lgszolnoki/CPU_Board/Eagle/rcbussbc.brd

## EAGLE design Eagle/rcbussbc.brd (2024-07-18)

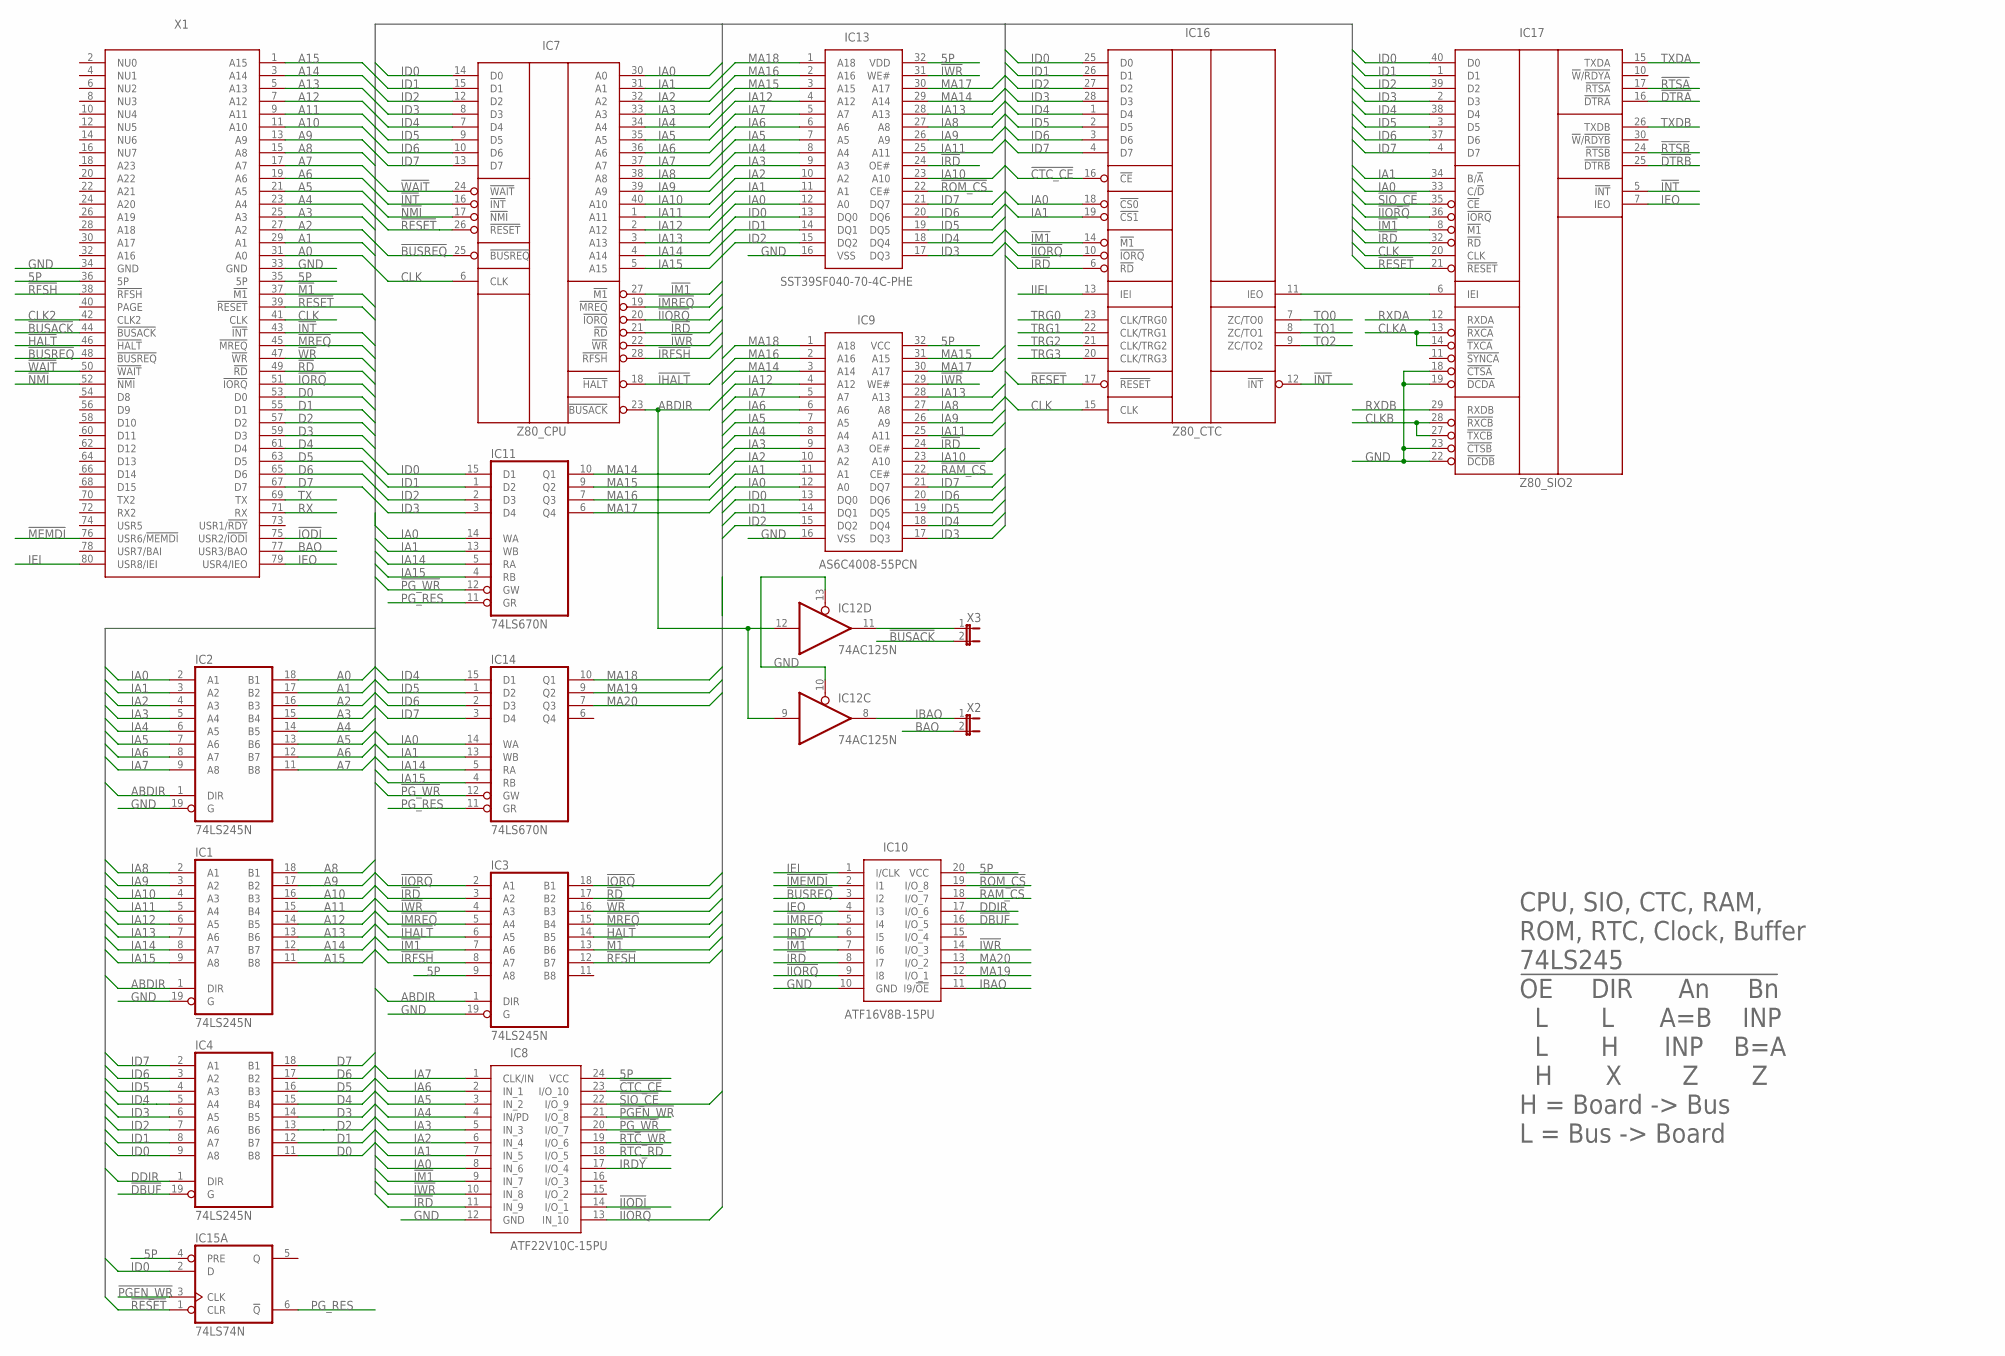
[picture p1: schematic rcbussbc.sch, sheet 1]

Parts:
IC1, IC2, IC3, IC4: 74LS245N; DIL20
IC7: Z80_CPU; DIP1612W53P254L5232H406Q40N
IC8: ATF22V10C-15PU; DIP794W56P254L3188H533Q24N
IC9: AS6C4008-55PCN; DIP1524W58P254L4191H406Q32N
IC10: ATF16V8B-15PU; DIP794W59P254L2591H533Q20N
IC11, IC14: 74LS670N; DIL16
IC12: 74AC125N; DIL14
IC13: SST39SF040-70-4C-PHE; DIP1556W56P254L4191H508Q32N
IC15: 74LS74N; DIL14
IC16: Z80_CTC; DIL28
IC17: Z80_SIO2; DIP1612W53P254L5232H406Q40N
X1: RCBUS_80_RA; RC2014_80_RA
X2, X3: JP1E; JP1

Connections:
5P: IC3.9 (A8), IC8.24 (VCC), IC9.32 (VCC), IC10.20 (VCC), IC13.32 (VDD), IC15.4 (PRE), X1.35 (5P), X1.36 (5P); also elsewhere on the board
!BUSACK: X1.44 (!BUSACK), X3.2
!BUSREQ: IC7.25 (!BUSREQ), IC10.3 (I2), X1.48 (!BUSREQ)
!CTC_CE: IC8.23 (I/O_10), IC16.16 (!CE)
!DBUF: IC4.19 (G), IC10.16 (I/O_5)
!DTRA: IC17.16 (!DTRA); also elsewhere on the board
!DTRB: IC17.25 (!DTRB); also elsewhere on the board
!HALT: IC3.14 (B5), X1.46 (!HALT)
!IHALT: IC3.6 (A5), IC7.18 (!HALT)
!IIODI: IC8.14 (I/O_1); also elsewhere on the board
!IIORQ: IC3.2 (A1), IC7.20 (!IORQ), IC8.13 (IN_10), IC10.9 (I8), IC16.10 (!IORQ), IC17.36 (!IORQ)
!IM1: IC3.7 (A6), IC7.27 (!M1), IC8.9 (IN_7), IC10.7 (I6), IC16.14 (!M1), IC17.8 (!M1)
!IMEMDI: IC10.2 (I1); also elsewhere on the board
!IMREQ: IC3.5 (A4), IC7.19 (!MREQ), IC10.5 (I4)
!INT: IC7.16 (!INT), IC16.12 (!INT), IC17.5 (!INT), X1.43 (!INT)
!IODI: X1.75 (USR2/!IODI); also elsewhere on the board
!IORQ: IC3.18 (B1), X1.51 (!IORQ)
!IRD: IC3.3 (A2), IC7.21 (!RD), IC8.11 (IN_9), IC9.24 (OE#), IC10.8 (I7), IC13.24 (OE#), IC16.6 (!RD), IC17.32 (!RD)
!IRFSH: IC3.8 (A7), IC7.28 (!RFSH)
!IWR: IC3.4 (A3), IC7.22 (!WR), IC8.10 (IN_8), IC9.29 (WE#), IC10.14 (I/O_3), IC13.31 (WE#)
!M1: IC3.13 (B6), X1.37 (!M1)
!MEMDI: X1.76 (USR6/!MEMDI); also elsewhere on the board
!MREQ: IC3.15 (B4), X1.45 (!MREQ)
!NMI: IC7.17 (!NMI), X1.52 (!NMI)
!PGEN_WR: IC8.21 (I/O_8), IC15.3 (CLK)
!PG_WR: IC8.20 (I/O_7), IC11.12 (GW), IC14.12 (GW)
!RAM_CS: IC9.22 (CE#), IC10.18 (I/O_7)
!RD: IC3.17 (B2), X1.49 (!RD)
!RESET: IC7.26 (!RESET), IC15.1 (CLR), IC16.17 (!RESET), IC17.21 (!RESET), X1.39 (!RESET); also elsewhere on the board
!RFSH: IC3.12 (B7), X1.38 (!RFSH)
!ROM_CS: IC10.19 (I/O_8), IC13.22 (CE#)
!RTC_RD: IC8.18 (I/O_5); also elsewhere on the board
!RTC_WR: IC8.19 (I/O_6); also elsewhere on the board
!RTSA: IC17.17 (!RTSA); also elsewhere on the board
!RTSB: IC17.24 (!RTSB); also elsewhere on the board
!SIO_CE: IC8.22 (I/O_9), IC17.35 (!CE)
!WAIT: IC7.24 (!WAIT), X1.50 (!WAIT)
!WR: IC3.16 (B3), X1.47 (!WR)
A0: IC2.18 (B1), X1.31 (A0)
A1: IC2.17 (B2), X1.29 (A1)
A2: IC2.16 (B3), X1.27 (A2)
A3: IC2.15 (B4), X1.25 (A3)
A4: IC2.14 (B5), X1.23 (A4)
A5: IC2.13 (B6), X1.21 (A5)
A6: IC2.12 (B7), X1.19 (A6)
A7: IC2.11 (B8), X1.17 (A7)
A8: IC1.18 (B1), X1.15 (A8)
A9: IC1.17 (B2), X1.13 (A9)
A10: IC1.16 (B3), X1.11 (A10)
A11: IC1.15 (B4), X1.9 (A11)
A12: IC1.14 (B5), X1.7 (A12)
A13: IC1.13 (B6), X1.5 (A13)
A14: IC1.12 (B7), X1.3 (A14)
A15: IC1.11 (B8), X1.1 (A15)
ABDIR: IC1.1 (DIR), IC2.1 (DIR), IC3.1 (DIR), IC7.23 (!BUSACK), IC12.9 (I), IC12.12 (I)
BAO: X1.77 (USR3/BAO), X2.2
CLK: IC7.6 (CLK), IC16.15 (CLK), IC17.20 (CLK), X1.41 (CLK); also elsewhere on the board
CLK2: X1.42 (CLK2); also elsewhere on the board
CLKA: IC17.13 (!RXCA), IC17.14 (!TXCA); also elsewhere on the board
CLKB: IC17.27 (!TXCB), IC17.28 (!RXCB); also elsewhere on the board
D0: IC4.11 (B8), X1.53 (D0)
D1: IC4.12 (B7), X1.55 (D1)
D2: IC4.13 (B6), X1.57 (D2)
D3: IC4.14 (B5), X1.59 (D3)
D4: IC4.15 (B4), X1.61 (D4)
D5: IC4.16 (B3), X1.63 (D5)
D6: IC4.17 (B2), X1.65 (D6)
D7: IC4.18 (B1), X1.67 (D7)
DDIR: IC4.1 (DIR), IC10.17 (I/O_6)
GND: IC1.19 (G), IC2.19 (G), IC3.19 (G), IC8.12 (GND), IC9.16 (VSS), IC10.10 (GND), IC12.10 (OE), IC12.13 (OE), IC13.16 (VSS), IC17.18 (!CTSA), IC17.19 (!DCDA), IC17.22 (!DCDB), IC17.23 (!CTSB), X1.33 (GND), X1.34 (GND); also elsewhere on the board
IA0: IC2.2 (A1), IC7.30 (A0), IC8.8 (IN_6), IC9.12 (A0), IC11.14 (WA), IC13.12 (A0), IC14.14 (WA), IC16.18 (!CS0), IC17.33 (C/!D)
IA1: IC2.3 (A2), IC7.31 (A1), IC8.7 (IN_5), IC9.11 (A1), IC11.13 (WB), IC13.11 (A1), IC14.13 (WB), IC16.19 (!CS1), IC17.34 (B/!A)
IA2: IC2.4 (A3), IC7.32 (A2), IC8.6 (IN_4), IC9.10 (A2), IC13.10 (A2)
IA3: IC2.5 (A4), IC7.33 (A3), IC8.5 (IN_3), IC9.9 (A3), IC13.9 (A3)
IA4: IC2.6 (A5), IC7.34 (A4), IC8.4 (IN/PD), IC9.8 (A4), IC13.8 (A4)
IA5: IC2.7 (A6), IC7.35 (A5), IC8.3 (IN_2), IC9.7 (A5), IC13.7 (A5)
IA6: IC2.8 (A7), IC7.36 (A6), IC8.2 (IN_1), IC9.6 (A6), IC13.6 (A6)
IA7: IC2.9 (A8), IC7.37 (A7), IC8.1 (CLK/IN), IC9.5 (A7), IC13.5 (A7)
IA8: IC1.2 (A1), IC7.38 (A8), IC9.27 (A8), IC13.27 (A8)
IA9: IC1.3 (A2), IC7.39 (A9), IC9.26 (A9), IC13.26 (A9)
IA10: IC1.4 (A3), IC7.40 (A10), IC9.23 (A10), IC13.23 (A10)
IA11: IC1.5 (A4), IC7.1 (A11), IC9.25 (A11), IC13.25 (A11)
IA12: IC1.6 (A5), IC7.2 (A12), IC9.4 (A12), IC13.4 (A12)
IA13: IC1.7 (A6), IC7.3 (A13), IC9.28 (A13), IC13.28 (A13)
IA14: IC1.8 (A7), IC7.4 (A14), IC11.5 (RA), IC14.5 (RA)
IA15: IC1.9 (A8), IC7.5 (A15), IC11.4 (RB), IC14.4 (RB)
IBAO: IC10.11 (I9/!OE), IC12.8 (O), X2.1
ID0: IC4.9 (A8), IC7.14 (D0), IC9.13 (DQ0), IC11.15 (D1), IC13.13 (DQ0), IC15.2 (D), IC16.25 (D0), IC17.40 (D0); also elsewhere on the board
ID1: IC4.8 (A7), IC7.15 (D1), IC9.14 (DQ1), IC11.1 (D2), IC13.14 (DQ1), IC16.26 (D1), IC17.1 (D1)
ID2: IC4.7 (A6), IC7.12 (D2), IC9.15 (DQ2), IC11.2 (D3), IC13.15 (DQ2), IC16.27 (D2), IC17.39 (D2)
ID3: IC4.6 (A5), IC7.8 (D3), IC9.17 (DQ3), IC11.3 (D4), IC13.17 (DQ3), IC16.28 (D3), IC17.2 (D3)
ID4: IC4.5 (A4), IC7.7 (D4), IC9.18 (DQ4), IC13.18 (DQ4), IC14.15 (D1), IC16.1 (D4), IC17.38 (D4); also elsewhere on the board
ID5: IC4.4 (A3), IC7.9 (D5), IC9.19 (DQ5), IC13.19 (DQ5), IC14.1 (D2), IC16.2 (D5), IC17.3 (D5); also elsewhere on the board
ID6: IC4.3 (A2), IC7.10 (D6), IC9.20 (DQ6), IC13.20 (DQ6), IC14.2 (D3), IC16.3 (D6), IC17.37 (D6); also elsewhere on the board
ID7: IC4.2 (A1), IC7.13 (D7), IC9.21 (DQ7), IC13.21 (DQ7), IC14.3 (D4), IC16.4 (D7), IC17.4 (D7); also elsewhere on the board
IEI: IC10.1 (I/CLK), X1.80 (USR8/IEI); also elsewhere on the board
IEO: IC10.4 (I3), IC17.7 (IEO), X1.79 (USR4/IEO)
IIEI: IC16.13 (IEI); also elsewhere on the board
IRDY: IC8.17 (I/O_4), IC10.6 (I5)
MA14: IC9.3 (A14), IC11.10 (Q1), IC13.29 (A14); also elsewhere on the board
MA15: IC9.31 (A15), IC11.9 (Q2), IC13.3 (A15); also elsewhere on the board
MA16: IC9.2 (A16), IC11.7 (Q3), IC13.2 (A16); also elsewhere on the board
MA17: IC9.30 (A17), IC11.6 (Q4), IC13.30 (A17); also elsewhere on the board
MA18: IC9.1 (A18), IC13.1 (A18), IC14.10 (Q1); also elsewhere on the board
MA19: IC10.12 (I/O_1), IC14.9 (Q2)
MA20: IC10.13 (I/O_2), IC14.7 (Q3)
unnamed: IC16.11 (IEO), IC17.6 (IEI)
unnamed: IC12.11 (O), X3.1
PG_RES: IC11.11 (GR), IC14.11 (GR), IC15.6 (!Q)
RX: X1.71 (RX); also elsewhere on the board
RXDA: IC17.12 (RXDA); also elsewhere on the board
RXDB: IC17.29 (RXDB); also elsewhere on the board
TO0: IC16.7 (ZC/TO0); also elsewhere on the board
TO1: IC16.8 (ZC/TO1); also elsewhere on the board
TO2: IC16.9 (ZC/TO2); also elsewhere on the board
TRG0: IC16.23 (CLK/TRG0); also elsewhere on the board
TRG1: IC16.22 (CLK/TRG1); also elsewhere on the board
TRG2: IC16.21 (CLK/TRG2); also elsewhere on the board
TRG3: IC16.20 (CLK/TRG3); also elsewhere on the board
TX: X1.69 (TX); also elsewhere on the board
TXDA: IC17.15 (TXDA); also elsewhere on the board
TXDB: IC17.26 (TXDB); also elsewhere on the board

Notes on the sheet:
CPU, SIO, CTC, RAM, ROM, RTC, Clock, Buffer 74LS245 !OE DIR An Bn L L A=B INP L H INP B=A H X Z Z H = Board -> Bus L = Bus -> Board

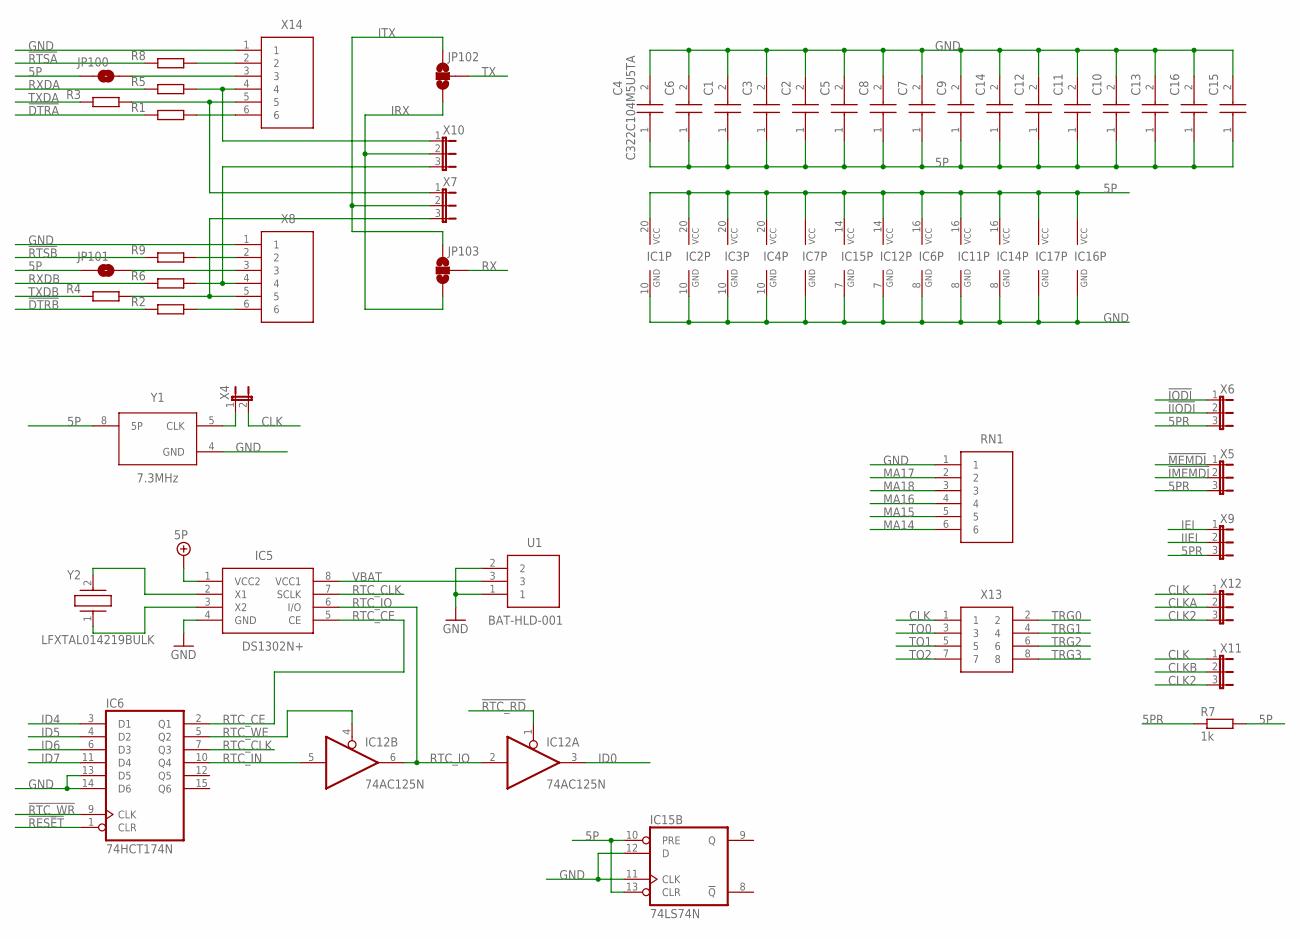
[picture p2: schematic rcbussbc.sch, sheet 2]

Parts:
C1, C2, C3, C4, C5, C6, C7, C8, C9, C10, C11, C12, C13, C14, C15, C16: C322C104M5U5TA; C322C104K1R5TA
IC1, IC2, IC3, IC4: 74LS245N; DIL20
IC5: DS1302N+; DIP762W56P254L938H457Q8N
IC6: 74HCT174N; DIL16
IC7: Z80_CPU; DIP1612W53P254L5232H406Q40N
IC11, IC14: 74LS670N; DIL16
IC12: 74AC125N; DIL14
IC15: 74LS74N; DIL14
IC16: Z80_CTC; DIL28
IC17: Z80_SIO2; DIP1612W53P254L5232H406Q40N
JP100, JP101: JUMPER-SMT_2_NO_SILK; SMT-JUMPER_2_NO_SILK
JP102, JP103: JUMPER-SMT_3_NO_SILK; SMT-JUMPER_3_NO_SILK
R1, R2, R3, R4, R5, R6, R7, R8, R9: 1k; 0207/10
RN1: 4606X-101-102LF; 4606X101102LF
U1: BAT-HLD-001; BATHLD001
X4: JP1E; JP1
X5, X6, X7, X9, X10, X11, X12: JP2E; JP2
X8, X14: TSW-106-08-T-S-RA; HDRRA6W64P254_1X6_1524X254X309
X13: 10129381-908002BLF; HDRV8W67P254_2X4_1016X483X858P
Y1: 7.3MHz; ECS-2100AX-200
Y2: LFXTAL014219BULK

Connections:
5P: C1.1 (+), C2.1 (+), C3.1 (+), C4.1 (+), C5.1 (+), C6.1 (+), C7.1 (+), C8.1 (+), C9.1 (+), C10.1 (+), C11.1 (+), C12.1 (+), C13.1 (+), C14.1 (+), C15.1 (+), C16.1 (+), IC1.20 (VCC), IC2.20 (VCC), IC3.20 (VCC), IC4.20 (VCC), IC5.1 (VCC2), IC6.16 (VCC), IC7.11 (VCC), IC11.16 (VCC), IC12.14 (VCC), IC14.16 (VCC), IC15.10 (PRE), IC15.13 (CLR), IC15.14 (VCC), IC16.24 (VCC), IC17.9 (VCC), JP100.1, JP101.1, R7.2, Y1.8 (5P); also elsewhere on the board
5PR: R7.1, X5.3, X6.3, X9.3
!DTRA: R1.1; also elsewhere on the board
!DTRB: R2.1; also elsewhere on the board
!IIODI: X6.2; also elsewhere on the board
!IMEMDI: X5.2; also elsewhere on the board
!IODI: X6.1; also elsewhere on the board
!MEMDI: X5.1; also elsewhere on the board
!RESET: IC6.1 (CLR); also elsewhere on the board
!RTC_RD: IC12.1 (OE); also elsewhere on the board
!RTC_WR: IC6.9 (CLK); also elsewhere on the board
!RTSA: R8.1; also elsewhere on the board
!RTSB: R9.1; also elsewhere on the board
CLK: X4.2, X11.1, X12.1, X13.1; also elsewhere on the board
CLK2: X11.3, X12.3; also elsewhere on the board
CLKA: X12.2; also elsewhere on the board
CLKB: X11.2; also elsewhere on the board
GND: C1.2 (-), C2.2 (-), C3.2 (-), C4.2 (-), C5.2 (-), C6.2 (-), C7.2 (-), C8.2 (-), C9.2 (-), C10.2 (-), C11.2 (-), C12.2 (-), C13.2 (-), C14.2 (-), C15.2 (-), C16.2 (-), IC1.10 (GND), IC2.10 (GND), IC3.10 (GND), IC4.10 (GND), IC5.4 (GND), IC6.8 (GND), IC6.13 (D5), IC6.14 (D6), IC7.29 (GND), IC11.8 (GND), IC12.7 (GND), IC14.8 (GND), IC15.7 (GND), IC15.11 (CLK), IC15.12 (D), IC16.5 (GND), IC17.31 (GND), RN1.1, U1.1, U1.2, X8.1, X14.1, Y1.4 (GND); also elsewhere on the board
ID0: IC12.3 (O); also elsewhere on the board
ID4: IC6.3 (D1); also elsewhere on the board
ID5: IC6.4 (D2); also elsewhere on the board
ID6: IC6.6 (D3); also elsewhere on the board
ID7: IC6.11 (D4); also elsewhere on the board
IEI: X9.1; also elsewhere on the board
IIEI: X9.2; also elsewhere on the board
IRX: JP102.1, JP103.1, X10.2
ITX: JP102.3, JP103.3, X7.2
MA14: RN1.6; also elsewhere on the board
MA15: RN1.5; also elsewhere on the board
MA16: RN1.4; also elsewhere on the board
MA17: RN1.2; also elsewhere on the board
MA18: RN1.3; also elsewhere on the board
unnamed: IC5.3 (X2), Y2.1
unnamed: X4.1, Y1.5 (CLK)
unnamed: JP100.2, X14.3
unnamed: R8.2, X14.2
unnamed: R5.2, X10.1, X14.4
unnamed: R3.2, X7.1, X14.5
unnamed: R1.2, X14.6
unnamed: JP101.2, X8.3
unnamed: R9.2, X8.2
unnamed: R6.2, X8.4, X10.3
unnamed: IC5.2 (X1), Y2.2
unnamed: R4.2, X7.3, X8.5
unnamed: R2.2, X8.6
RTC_CE: IC5.5 (CE), IC6.2 (Q1)
RTC_CLK: IC5.7 (SCLK), IC6.7 (Q3)
RTC_IN: IC6.10 (Q4), IC12.5 (I)
RTC_IO: IC5.6 (I/O), IC12.2 (I), IC12.6 (O)
RTC_WE: IC6.5 (Q2), IC12.4 (OE)
RX: JP103.2; also elsewhere on the board
RXDA: R5.1; also elsewhere on the board
RXDB: R6.1; also elsewhere on the board
TO0: X13.3; also elsewhere on the board
TO1: X13.5; also elsewhere on the board
TO2: X13.7; also elsewhere on the board
TRG0: X13.2; also elsewhere on the board
TRG1: X13.4; also elsewhere on the board
TRG2: X13.6; also elsewhere on the board
TRG3: X13.8; also elsewhere on the board
TX: JP102.2; also elsewhere on the board
TXDA: R3.1; also elsewhere on the board
TXDB: R4.1; also elsewhere on the board
VBAT: IC5.8 (VCC1), U1.3

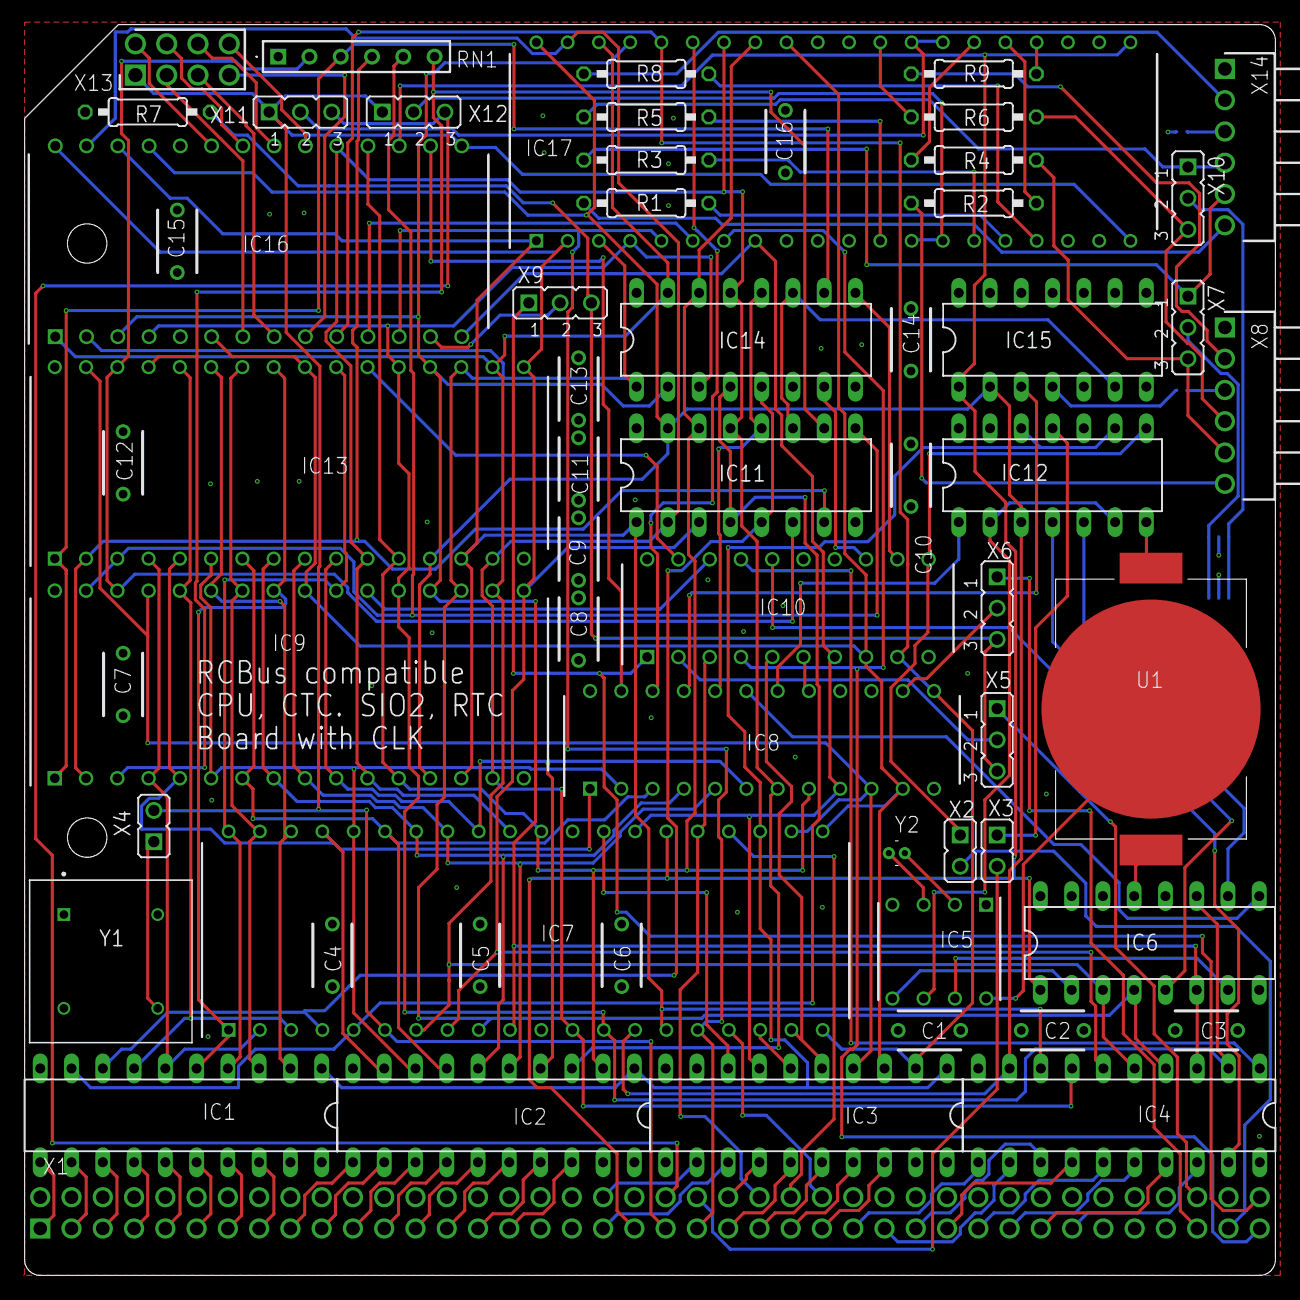
[picture p3: board rcbussbc.brd from above]

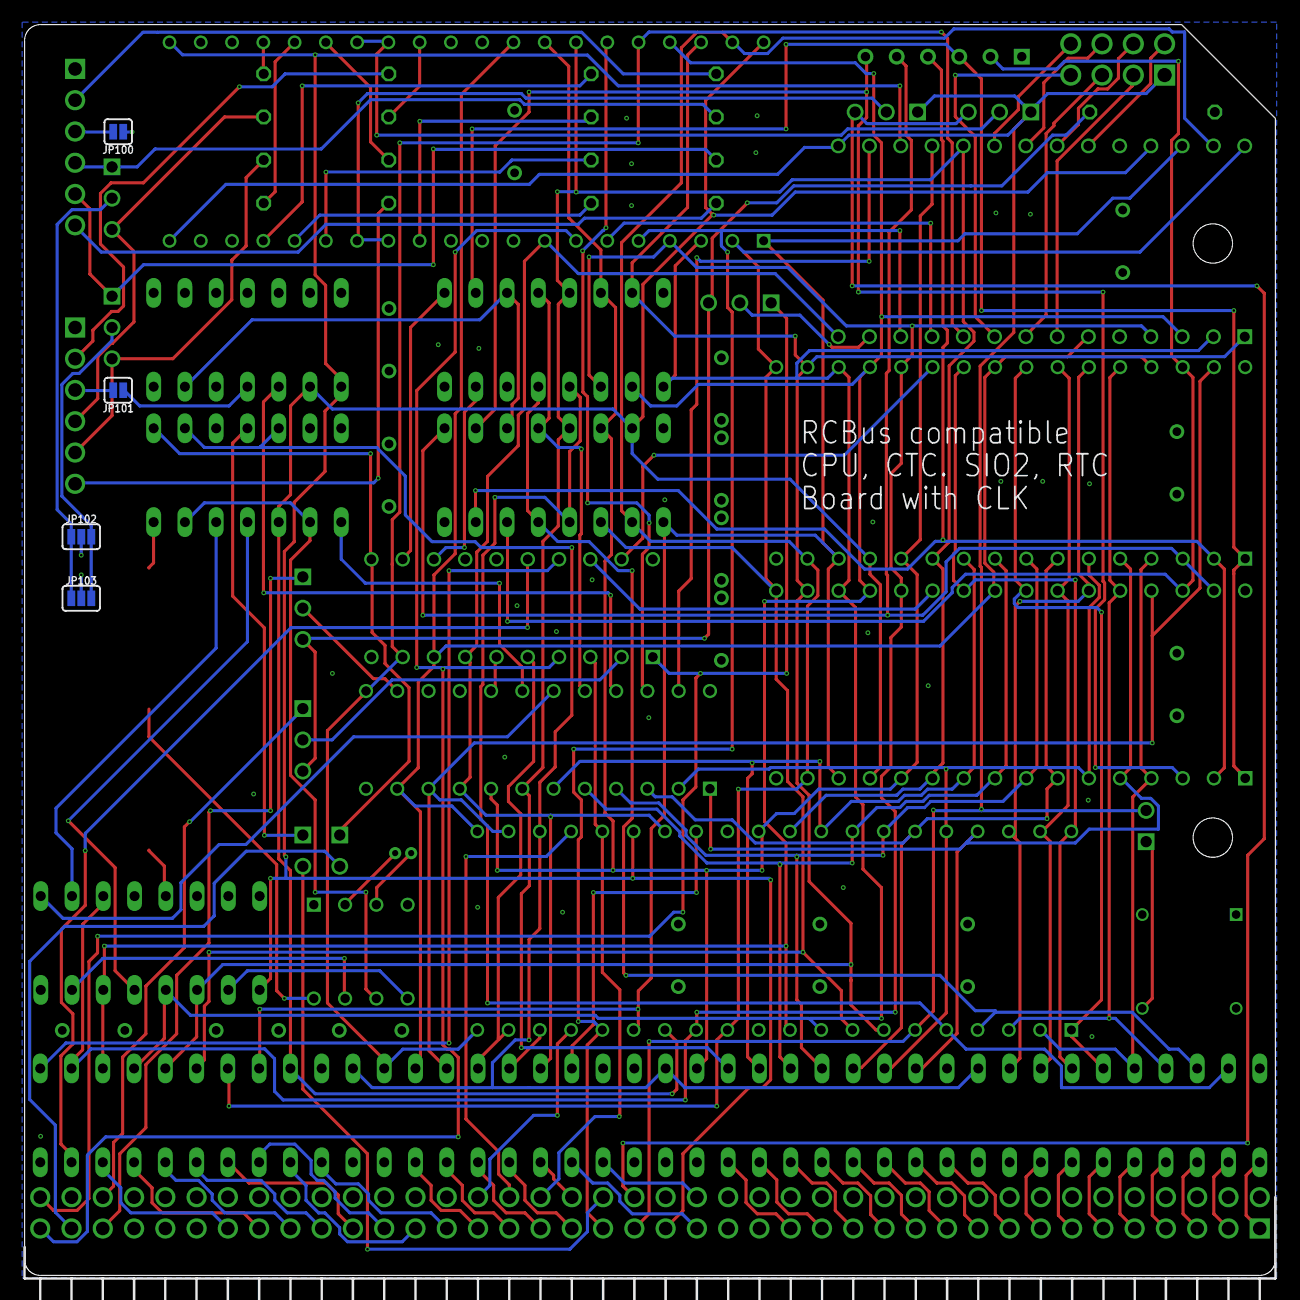
[picture p4: board rcbussbc.brd from below]

Board: 4 copper layers, 101.6 x 101.6 mm, 64 parts (4 on the bottom side), 144 nets.
